trudant/987-997-Comfort-Seat-Hack/997-987_seat_resources.md

## 997/987 Seat Diagram

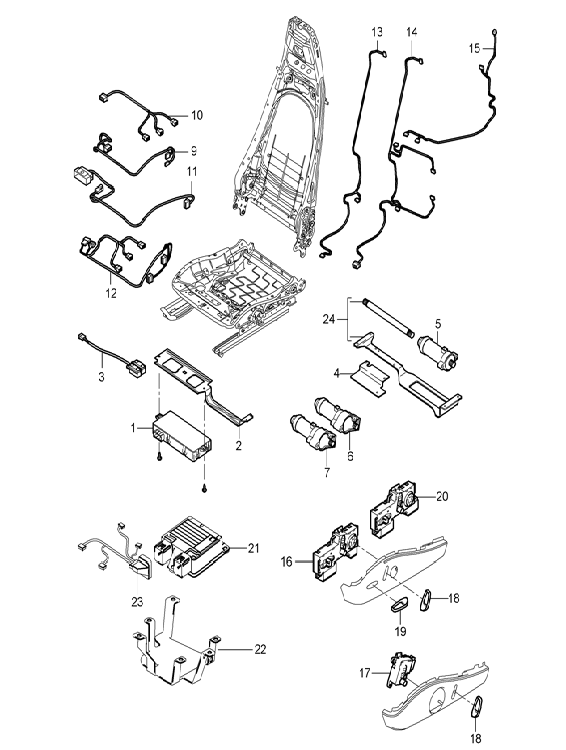
[picture p22: diagrams/image7.png]
Boxster Wiring Harnesses 05- Boxster S Control Unit 05- Switch Sports Seat


*Note this diagram has featues of both memory and non-memory seats all integrated into a singal illustration.*

| Pos | Part Number | Description | Qty. | Year | Which Seat? |
| --- | --- | --- | ---: | --- | --- |
| 1 | 99761853707 | control unit seating position control | 1 | **2005-2008** | **Driver** |
| 2 | 99752164301 | bracket - control unit seating position control | 1 | **2005-2008** | **Driver** |
| 3 | 99761372500V05 | Seat Adj Switch - Galvano Silver | 1 | **2005-2008** | **Driver** |
| -3 | 99761372600V05 | Seat Adj Switch - Galvano Silver | 1 | **2005-2008** | **Passenger** |
| 4 | 99752134300 | support electric motor | 1 | **2005-2008** | **Driver / Passenger** |
| 5 | 99762432200 | electric motor seat adjuster lengthways without memory | 1 | **2005-2008** | **Driver / Passenger** |
| -5 | 99762433200 | electric motor seat adjuster lengthways with memory | 1 | **2005-2008** | **Driver / Passenger** |
| 6 | 99762432200 | electric motor seat adjuster height adjustment without memory | 1 | **2005-2008** | **Driver / Passenger** |
| -6 | 99762433200 | electric motor seat adjuster height adjustment with memory | 1 | **2005-2008** | **Driver / Passenger** |
| 7 | 99762432300 | electric motor seat adjuster tilt angle without memory | 1 | **2005-2008** | **Driver / Passenger** |
| -7 | 99762433300 | electric motor seat adjuster tilt angle with memory | 1 | **2005-2008** | **Driver / Passenger** |
| 9 | 99761268400 | wiring harness switch seat adjuster memory | 1 | **2005-2008** | **Driver / Passenger** |
| 10 | 99761269000 | wiring harness height adjustment lengthways memory | 1 | **2005-2008** | **Driver / Passenger** |
| 11 | 99761268201 | wiring harness - switch | 1 | **2005-2008** | **Driver / Passenger** |
| 12 | 99761269101 | wiring harness switch without memory | 1 | **2005-2007** | **Driver / Passenger** |
| 12 | 99761269102 | wiring harness switch without memory | 1 | **2008** | **Driver / Passenger** |
| 13 | 99761268900 | wiring harness lumbar support without memory | 1 | **2005-2008** | **Driver / Passenger** |
| 14 | 99761269201 | wiring harness backrest lumbar with memory | 1 | **2005-2008** | **Driver / Passenger** |
| 15 | 99761268501 | wiring harness - without memory | 1 | **2005-2008** | **Driver** |
| -15 | 99761268601 | wiring harness - without memory | 1 | **2005-2008** | **Passenger** |
| 16 | 99761372101V05 | switch seat adjuster memory switch | 1 | **2005-2008** | **Driver** |
| -16 | 99761372201V05 | switch seat adjuster memory switch | 1 | **2005-2008** | **Passenger** |
| 17 | 99761371301 | switch seat adjuster manually adjustable | 1 | **2005-2008** | **Driver** |
| -17 | 99761371401 | switch seat adjuster manually adjustable | 1 | **2005-2008** | **Passenger** |
| 18 | 99752163101V05 | control button, backrest - galvano silver | 1 | **2005-2008** | **Driver / Passenger** |
| 19 | 99752163303V05 | control button, Seat Cushion | 1 | **2005-2008** | **Driver / Passenger** |
| 20 | 99761371702V05 | switch seat adjuster without memory | 1 | **2005-2008** | **Driver** |
| -20 | 99761371801V05 | switch seat adjuster without memory | 1 | **2005-2008** | **Passenger** |
| 21 | 99761823305 | control unit - seat occupancy detection | 1 | **2005-2008** | **Passenger** |
| 23 | 99761268801 | wiring harness - seat occupancy detection | 1 | **2006-2008** | **Passenger** |
| -24 | 99752190100 | repair kit pliable shaft engine bracket | 1 |  |  |
| - | 99965097340 | clip mount wiring harness seat occupancy detection | 1 | **2005-2008** | **Driver / Passenger** |

## Seat Control Module Wiring Diagram

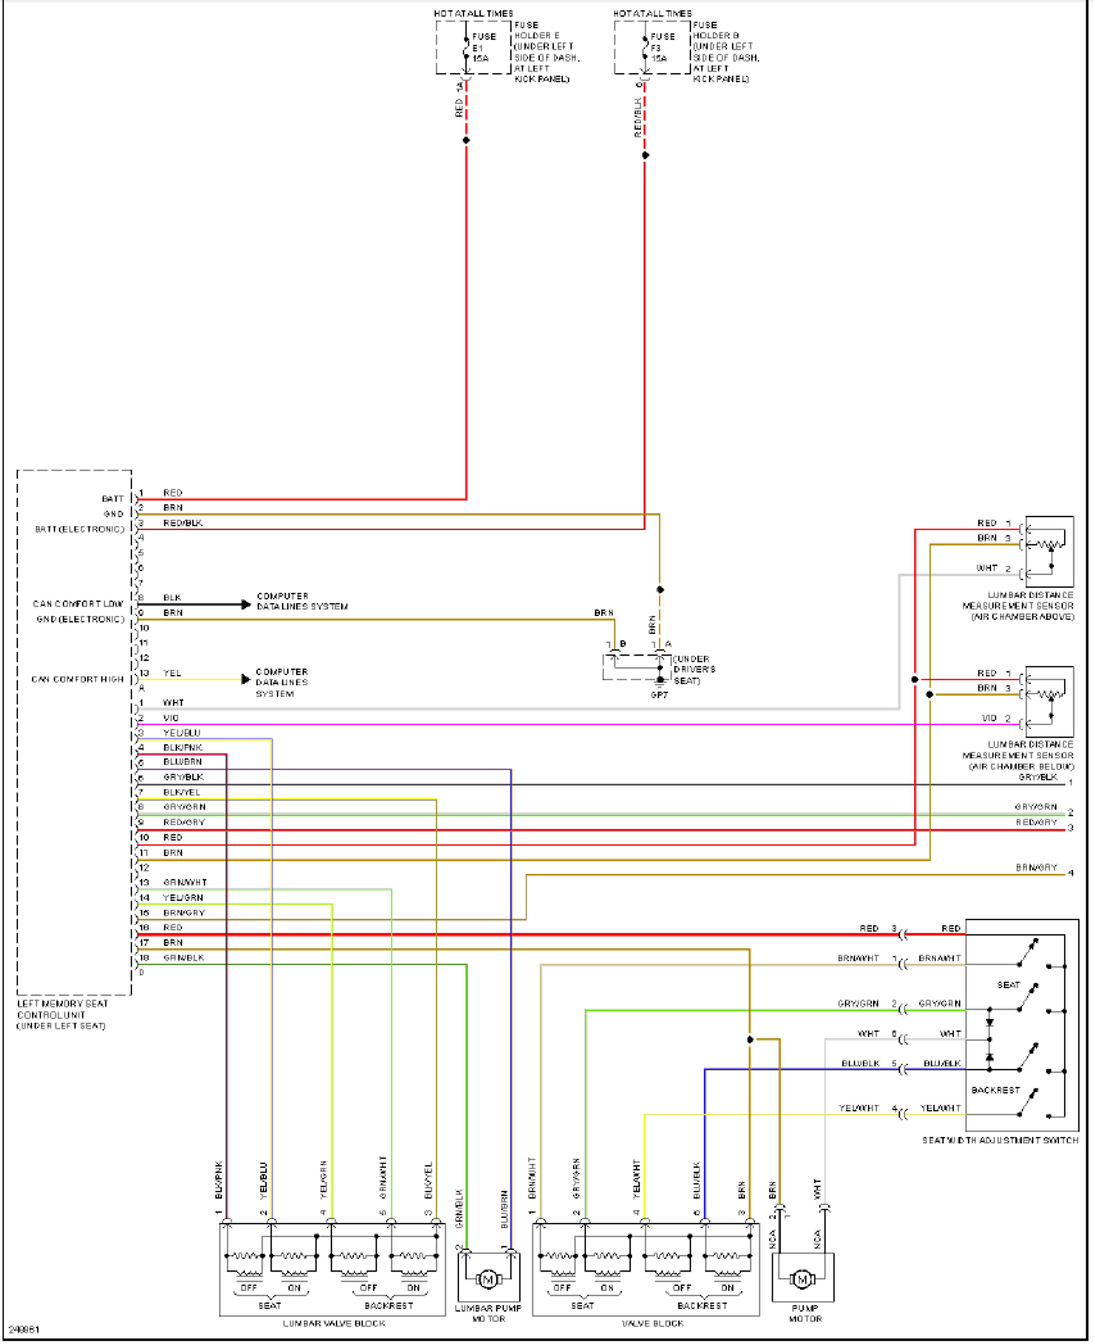
[picture p23: diagrams/image10.png]
seat_schematic_rainbow

Alternative, Easier to Read Diagram

<br>

997-seat-controller-connector       
The above two pictures show the “A” socket with connector unplugged (left) and the OEM connector plugged in (right).

Only 3 spade connections and 3 pins are used per the wiring diagram below.  Power comes from the vehicles Terminal 30 (always-on power). The CAN bus is the ‘Comfort CAN’ bus from the Gateway CU.

## Seating Position Control Unit Wiring

This first diagram seems to be the ‘official’ wiring diagram from the shop manual.   
(But the wiring names are not clear.) Second is much more clear but less official.

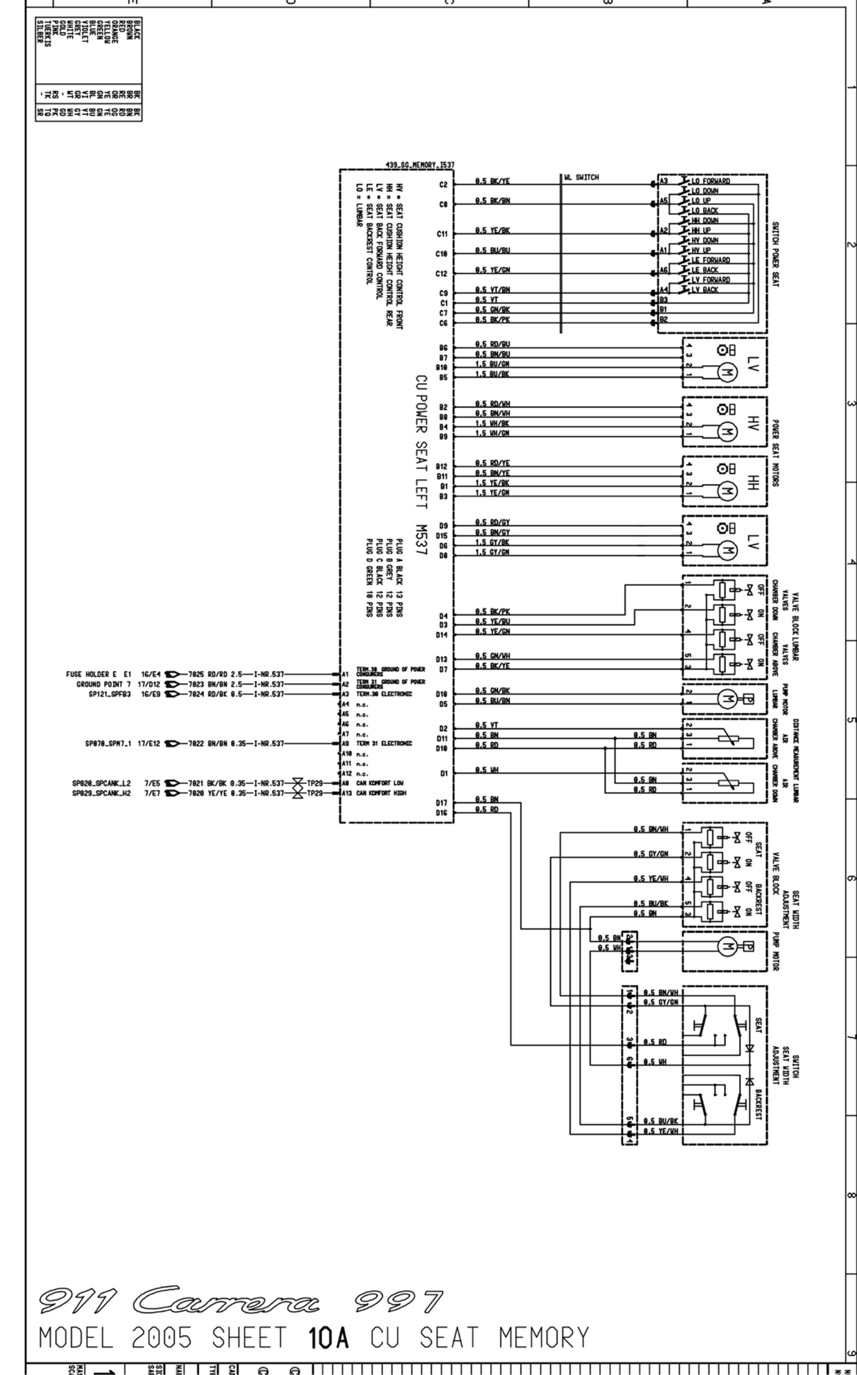
[picture p24: diagrams/image9.png]
seat_schematic_offical

Official Wiring Diagram

## System Level Wiring Diagram
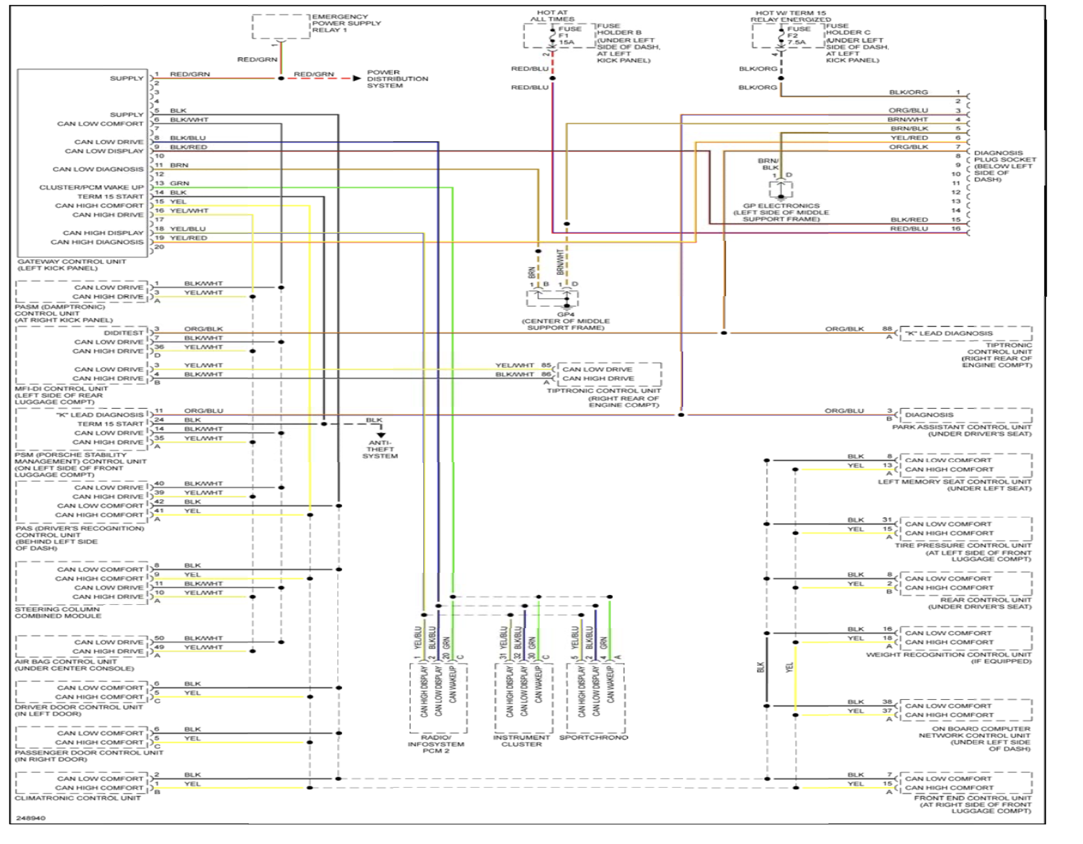
[picture p25: diagrams/987_system_wiring.png]
system_wiring

System Diagram for Comfort CAN

## ODBII Debug Port
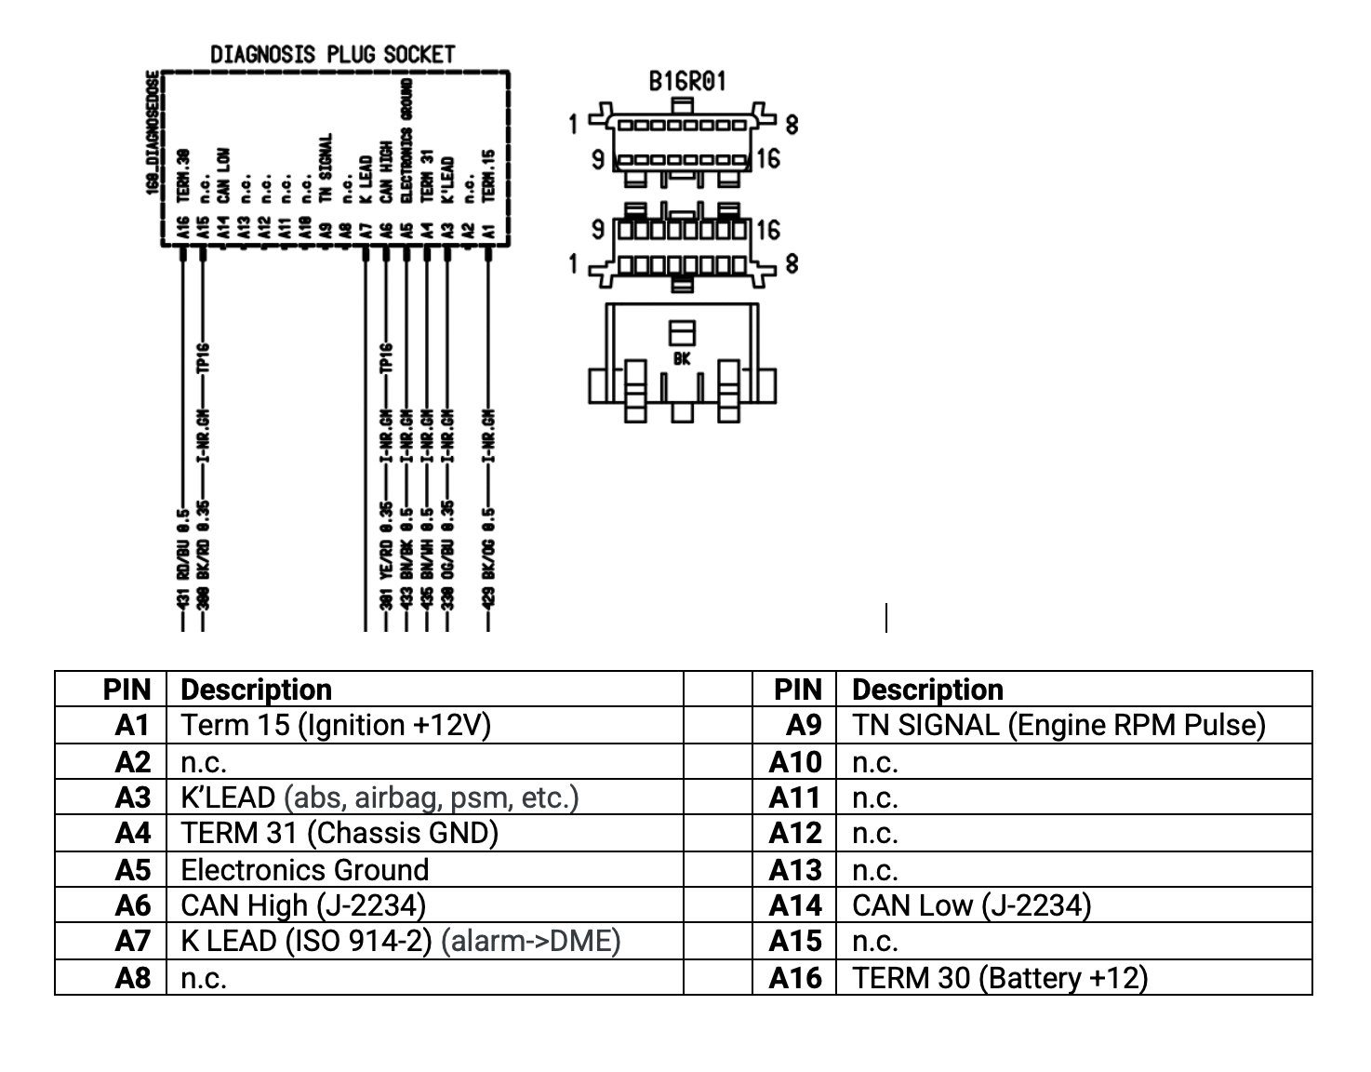
[picture p26: images/987-odbii.png]

ODBII Port for 987

<!-- Images Source Links -->

[image1]: diagrams/image1.png

[image2]: diagrams/image2.png

[image3]: diagrams/image3.png

[986_passenger_seat_wiring]: diagrams/986-passenger-seat-wiring.png

[yellow_connector]: diagrams/yellow-connector.png

[yellow_connector_clean]: diagrams/yellow_connector_clean.png

[987_seat_mechanical]: diagrams/image7.png

[seat_control_module_isometric]: diagrams/image8.png

[seat_schematic_offical]: diagrams/image9.png

[seat_schematic_rainbow]: diagrams/image10.png

[gateway_isometric_view]: diagrams/image11.png

[gateway_connector]: diagrams/image12.png

[gateway_schematic]: diagrams/image13.png

[door_ctrl_schematic]: diagrams/image14.png

[mem_switch_schematic]: diagrams/image15.png

[mem_button_photo]: diagrams/image16.png

[mem_button_graphic]: diagrams/image17.png

[mem_button_connector]: diagrams/image18.png

[odbii_connector]: diagrams/odbii_connector.png

[system_wiring]: diagrams/987_system_wiring.png

[image21]: diagrams/image21.png

[image22]: diagrams/image22.png

[image23]: diagrams/image23.png

[image24]: diagrams/image24.png

[image25]: diagrams/image25.png

[image26]: diagrams/image26.png

[image27]: diagrams/image27.png

[997-seat-controller-connector]: diagrams/997-seat-controller-connector.png

[997-seat-controller-top]: diagrams/997-seat-controller-top.png

[can_playback_harness]: diagrams/can_playback_schematic_base_config.png

[can_remove_resistor]: diagrams/can_remove_resistor.png

[aruduino_ide_manual_control]: diagrams/arduino-ide-manual-control.png
