trudant/987-997-Comfort-Seat-Hack/996-986_seat_resources.md

## 996/986 Seat Mechnical Diagram (Passenger)
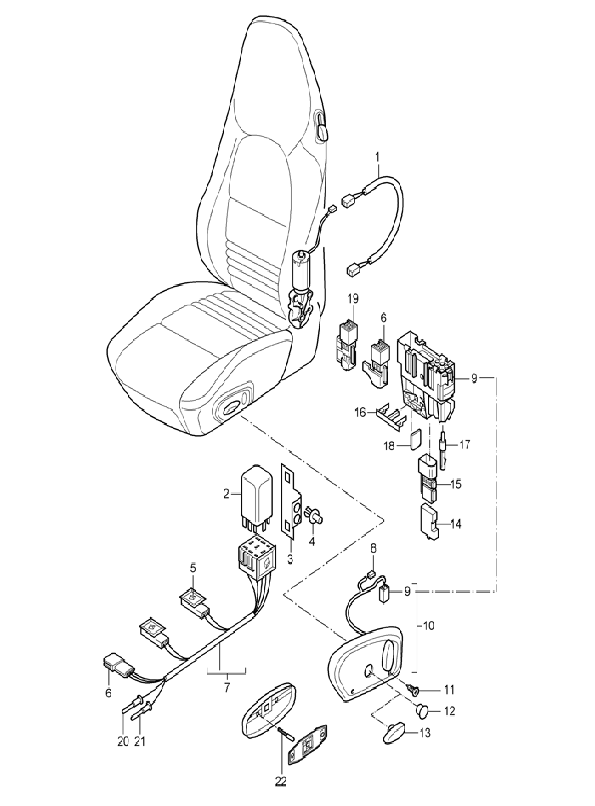
[picture p31: diagrams/image3.png]
Boxster Wiring Harnesses Switch Standard Seat Sports Seat

| Pos | Part Number | Description | Qty. Needed | Year | Which Seat? |
| --- | --- | --- | :---: | --- | --- |
| 1 | 99661254300 | wiring harness for backrest adjustment | 2 | 1997-2004 | Driver / Passenger |
| 2 | 99661852100 | control unit seat heater | 2 | 1997-2004 | Driver / Passenger |
| 3 | 99661853100 | support control unit | 2 | 1997-2004 | Driver / Passenger |
| 4 | 99959171240 | expansion rivet 6,0 x 12,0 | 2 | 1997-2002 | Driver / Passenger |
| -4 | 90014319102 | tapping screw | 4 | 2002-2004 | Driver / Passenger |
| 5 | 99965274840 | pin connector socket 2-pole seat heater | 2 | 1997-2004 | Driver / Passenger |
| 6 | 99965021640 | pin connector socket 4-pole black to seat heather button | 1 | 1997-2004 | Driver / Passenger |
| 7 | 99661254001 | wiring harness seat heater | 2 | 1997-2004 | Driver |
| 8 | 99965274740 | pin connector socket 2-pole for backrest adjustment | 1 | 1997-2004 | Driver / Passenger |
| 9 | 99965018040 | pin connector socket 6-pole wiring harness passenger compartment | 2 | 1997-2004 | Driver |
| 10 | 99661371300EBO | seat adjustment  black/black-grey | 1 | 1997-2004 | Driver |
| 10 | 99661371401EJM | seat adjustment switch grey/black |  | 1999-2004 | Driver / Passenger |
| 10 | 99661371401A03 | seat adjustment switch black |  | 1997-2004 | Driver / Passenger |
| 11 | 99991917302 | countersunk-head screw 3,0 x 18 | 4 | 1997-2004 | Driver / Passenger |
| 12 | 9966137110001C | dummy plug switch |  | 1997-2004 | Driver / Passenger |
| 13 | 98652162700 | handle height adjustment | 1 | 1997-2004 | Driver |
| -13 | 98652162800 | handle height adjustment | 1 | 1997-2004 | Passenger |
| 14 | 99965024840 | cap | 2 | 1997-2004 | Driver / Passenger |
| 15 | 99965025040 | pin connector socket 8-pole | 2 | 1997-2004 | Driver / Passenger |
| 16 | 99965024740 | slide 6-pole | 2 | 1997-2004 | Driver / Passenger |
| 17 | 99965022540 | pin 2,5 | 2 | 1997-2004 | Driver / Passenger |
| 18 | 99965296040 | lid | 2 | 1997-2004 | Driver / Passenger |
| 19 | 99965021840 | pin connector socket 4-pole white | 2 | 1997-2004 | Driver / Passenger |
| 20 | 99965257022 | connector 0.5 - 1.0 qmm | X | 1997-2004 | Driver / Passenger |
| 21 | 99965257122 | connector 1.0 - 2.5 qmm | X | 1997-2004 | Driver / Passenger |

**Wiring diagrams and Info for 986/996 heated seats**  
[https://www.dennisvogel.com/heatedseats/](https://www.dennisvogel.com/heatedseats/)

<!-- Images Source Links -->

[image1]: diagrams/image1.png

[image2]: diagrams/image2.png

[image3]: diagrams/image3.png

[986_passenger_seat_wiring]: diagrams/986-passenger-seat-wiring.png

[yellow_connector]: diagrams/yellow-connector.png

[yellow_connector_clean]: diagrams/yellow_connector_clean.png

[987_seat_mechanical]: diagrams/image7.png

[seat_control_module_isometric]: diagrams/image8.png

[seat_schematic_offical]: diagrams/image9.png

[seat_schematic_rainbow]: diagrams/image10.png

[gateway_isometric_view]: diagrams/image11.png

[gateway_connector]: diagrams/image12.png

[gateway_schematic]: diagrams/image13.png

[door_ctrl_schematic]: diagrams/image14.png

[mem_switch_schematic]: diagrams/image15.png

[mem_button_photo]: diagrams/image16.png

[mem_button_graphic]: diagrams/image17.png

[mem_button_connector]: diagrams/image18.png

[odbii_connector]: diagrams/odbii_connector.png

[system_wiring]: diagrams/987_system_wiring.png

[image21]: diagrams/image21.png

[image22]: diagrams/image22.png

[image23]: diagrams/image23.png

[image24]: diagrams/image24.png

[image25]: diagrams/image25.png

[image26]: diagrams/image26.png

[image27]: diagrams/image27.png

[997-seat-controller-connector]: diagrams/997-seat-controller-connector.png

[997-seat-controller-top]: diagrams/997-seat-controller-top.png

[can_playback_harness]: diagrams/can_playback_schematic_base_config.png

[can_remove_resistor]: diagrams/can_remove_resistor.png

[aruduino_ide_manual_control]: diagrams/arduino-ide-manual-control.png
