trudant/987-997-Comfort-Seat-Hack/diagrams/image5.jpg

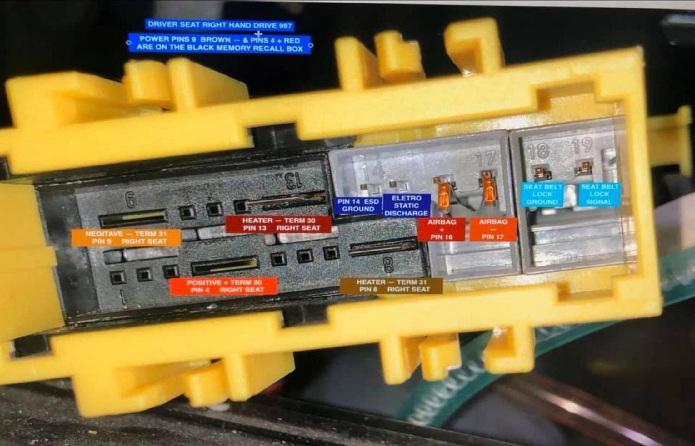
diagrams/image5.jpg
