trudant/987-997-Comfort-Seat-Hack/diagrams/image6.png

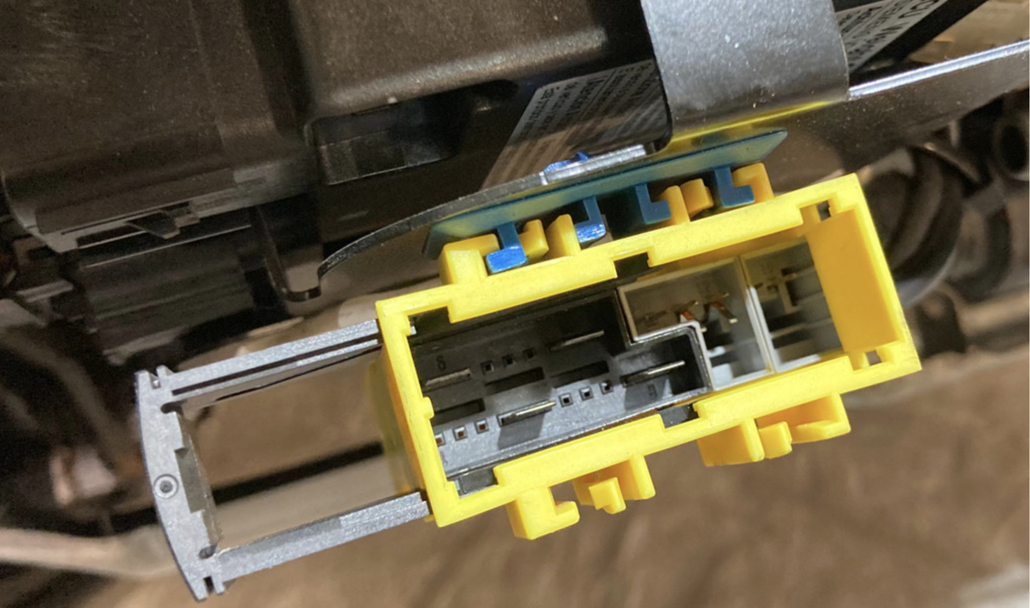
diagrams/image6.png
