trudant/987-997-Comfort-Seat-Hack/diagrams/image8.png

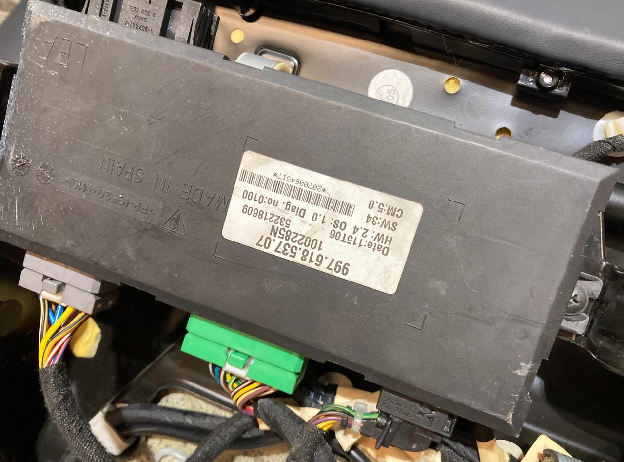
diagrams/image8.png
