trudant/987-997-Comfort-Seat-Hack/diagrams/image11.png

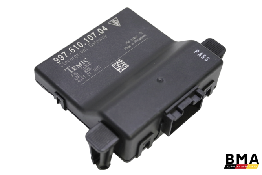
diagrams/image11.png
