trudant/987-997-Comfort-Seat-Hack/diagrams/image12.png

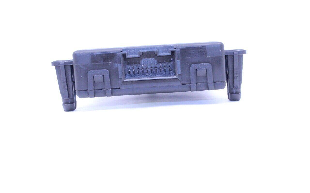
diagrams/image12.png
