trudant/987-997-Comfort-Seat-Hack/diagrams/image13.png

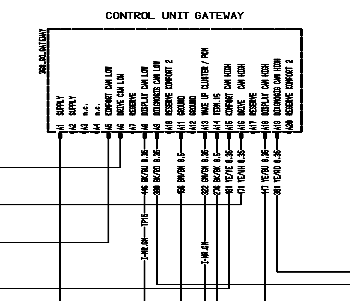
diagrams/image13.png
