trudant/987-997-Comfort-Seat-Hack/diagrams/image14.png

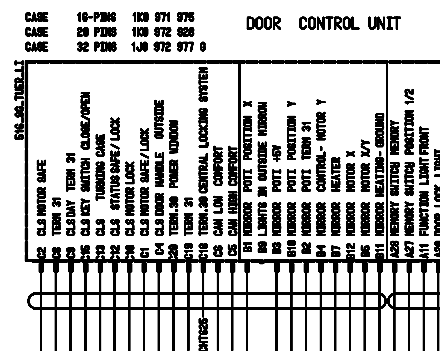
diagrams/image14.png
