trudant/987-997-Comfort-Seat-Hack/diagrams/image15.png

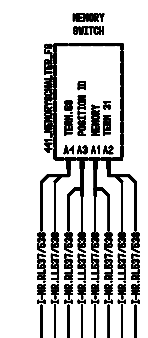
diagrams/image15.png
