trudant/987-997-Comfort-Seat-Hack/diagrams/image16.png

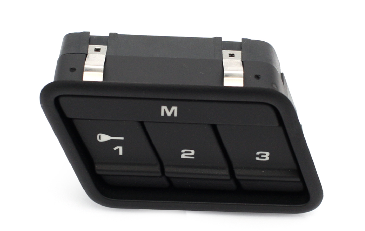
diagrams/image16.png
