trudant/987-997-Comfort-Seat-Hack/diagrams/image17.png

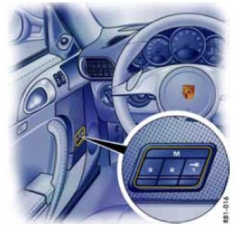
diagrams/image17.png
