trudant/987-997-Comfort-Seat-Hack/diagrams/image18.png

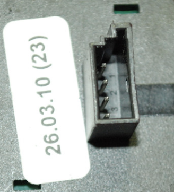
diagrams/image18.png
