trudant/987-997-Comfort-Seat-Hack/diagrams/image19.png

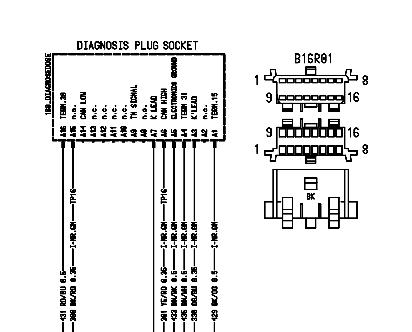
diagrams/image19.png
