trudant/987-997-Comfort-Seat-Hack/diagrams/image22.png

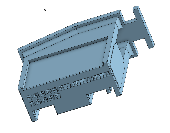
diagrams/image22.png
