trudant/987-997-Comfort-Seat-Hack/diagrams/image23.png

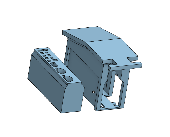
diagrams/image23.png
