trudant/987-997-Comfort-Seat-Hack/diagrams/image24.png

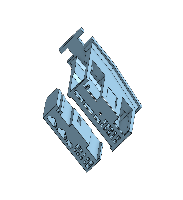
diagrams/image24.png
