trudant/987-997-Comfort-Seat-Hack/diagrams/image25.png

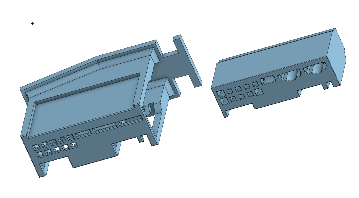
diagrams/image25.png
