trudant/987-997-Comfort-Seat-Hack/diagrams/image27.png

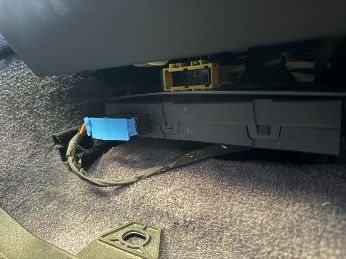
diagrams/image27.png
