trudant/987-997-Comfort-Seat-Hack/images/can-transceiver-iso-closed.jpg

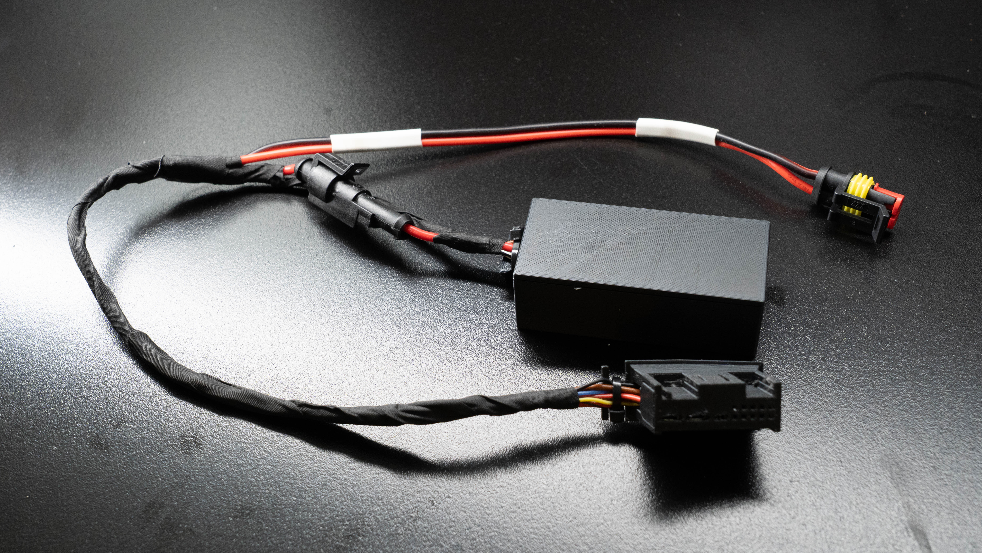
images/can-transceiver-iso-closed.jpg
