trudant/987-997-Comfort-Seat-Hack/images/can-transceivrer-all-done1.jpg

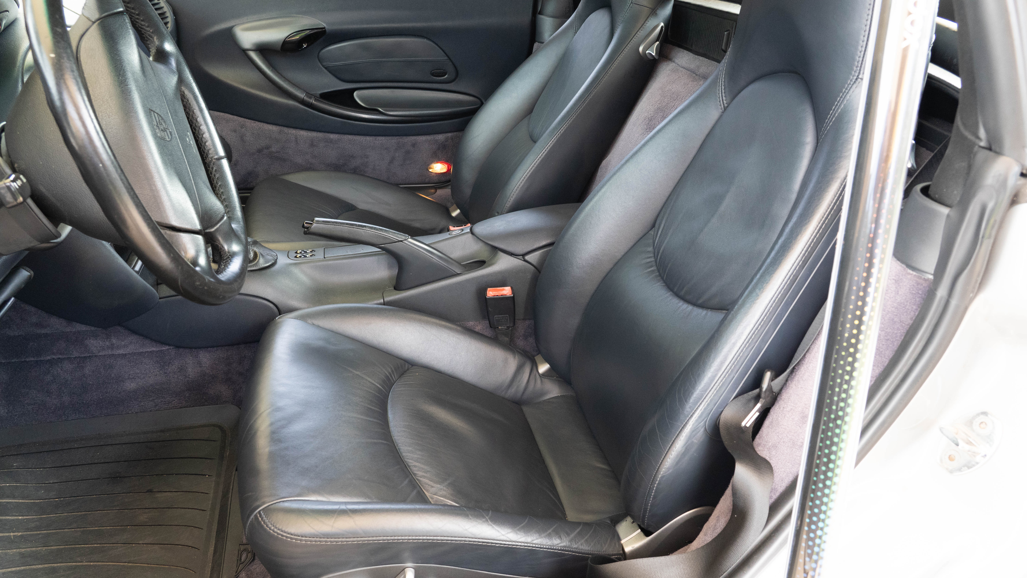
images/can-transceivrer-all-done1.jpg
