trudant/987-997-Comfort-Seat-Hack/images/ide-esp32.png

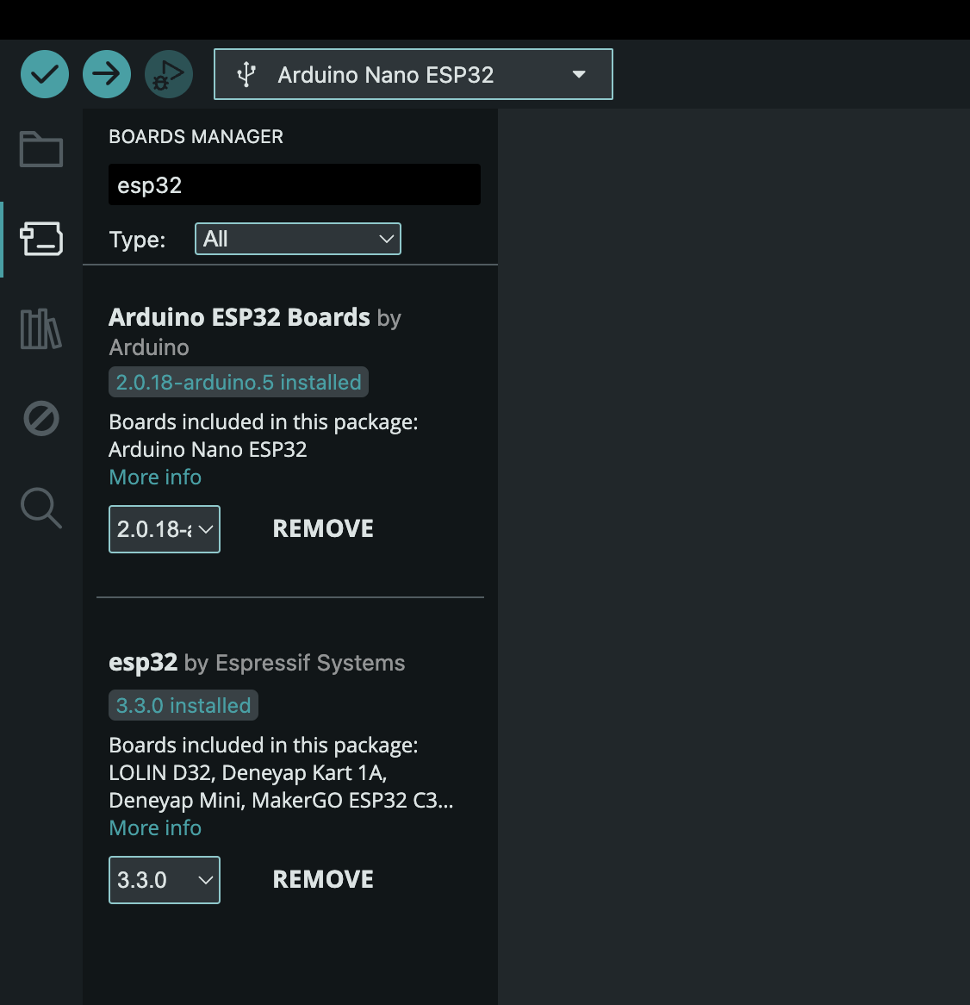
images/ide-esp32.png
