trudant/987-997-Comfort-Seat-Hack/images/image.png

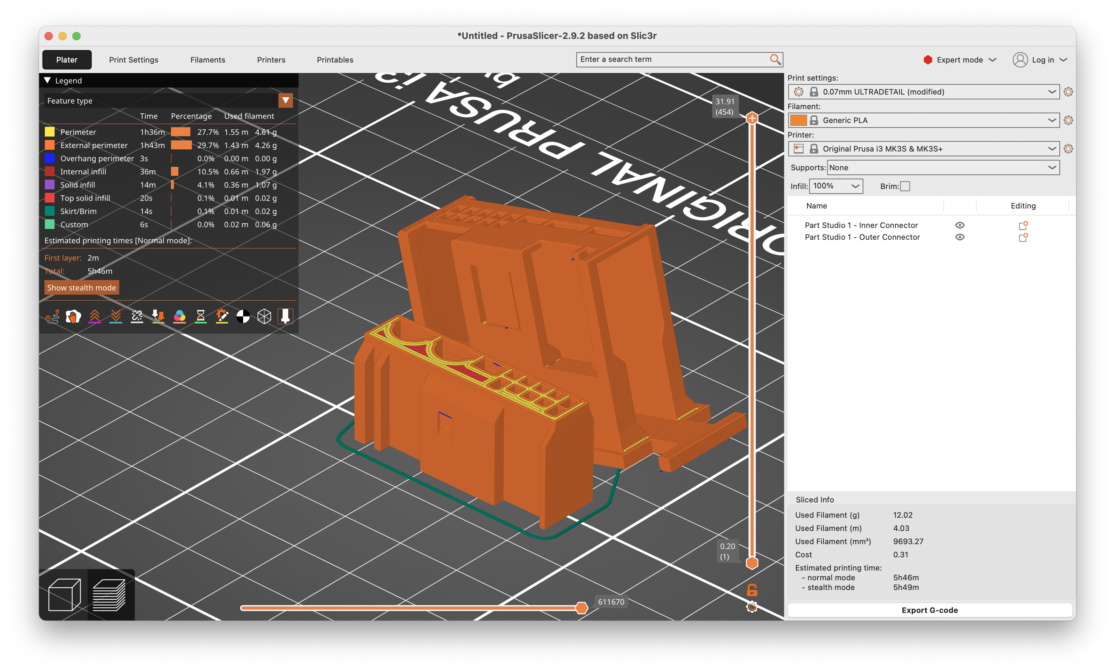
images/image.png
