trudant/987-997-Comfort-Seat-Hack/images/Screenshot 2025-08-31 at 9.09.06 AM.png

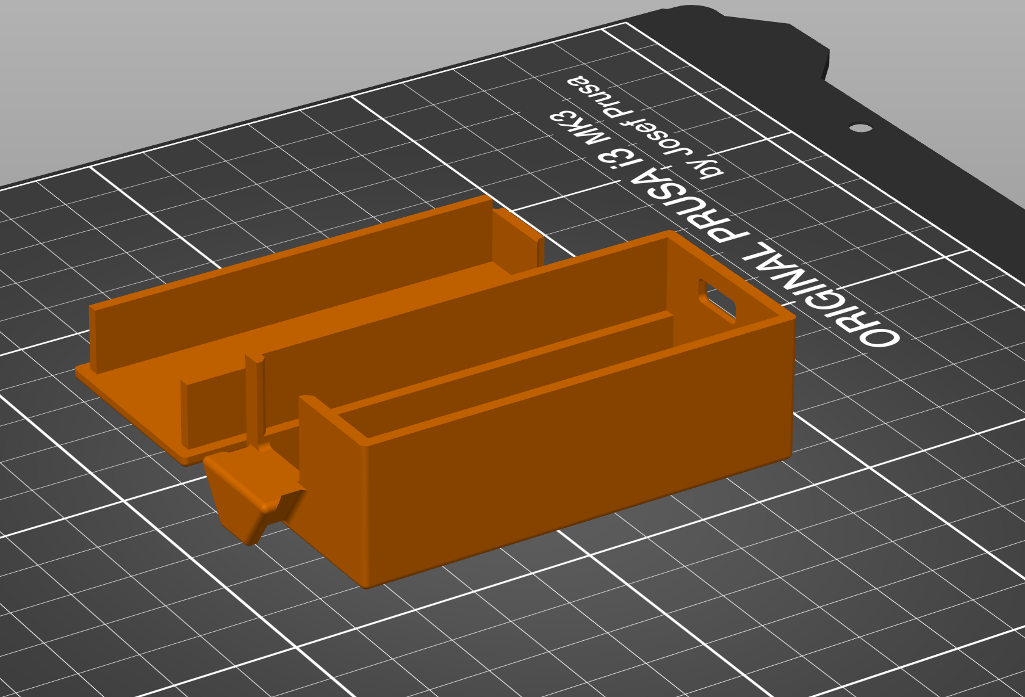
images/Screenshot 2025-08-31 at 9.09.06 AM.png
