trudant/987-997-Comfort-Seat-Hack/images/top-down-zoom.jpg

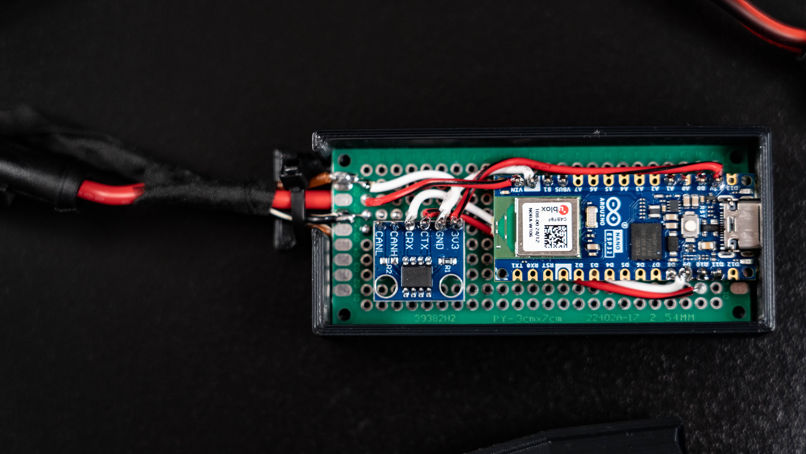
images/top-down-zoom.jpg
