trudant/987-997-Comfort-Seat-Hack/(commit log)

2025-09-01 inital commit
    [2025-4-4_canlog_1_savvycan.csv]
2025-09-01 adding button concept to CAN harness
2025-09-01 Updating wiring to match actual builds
